jurddle/Mood-Lamp/images/schematic.jpg

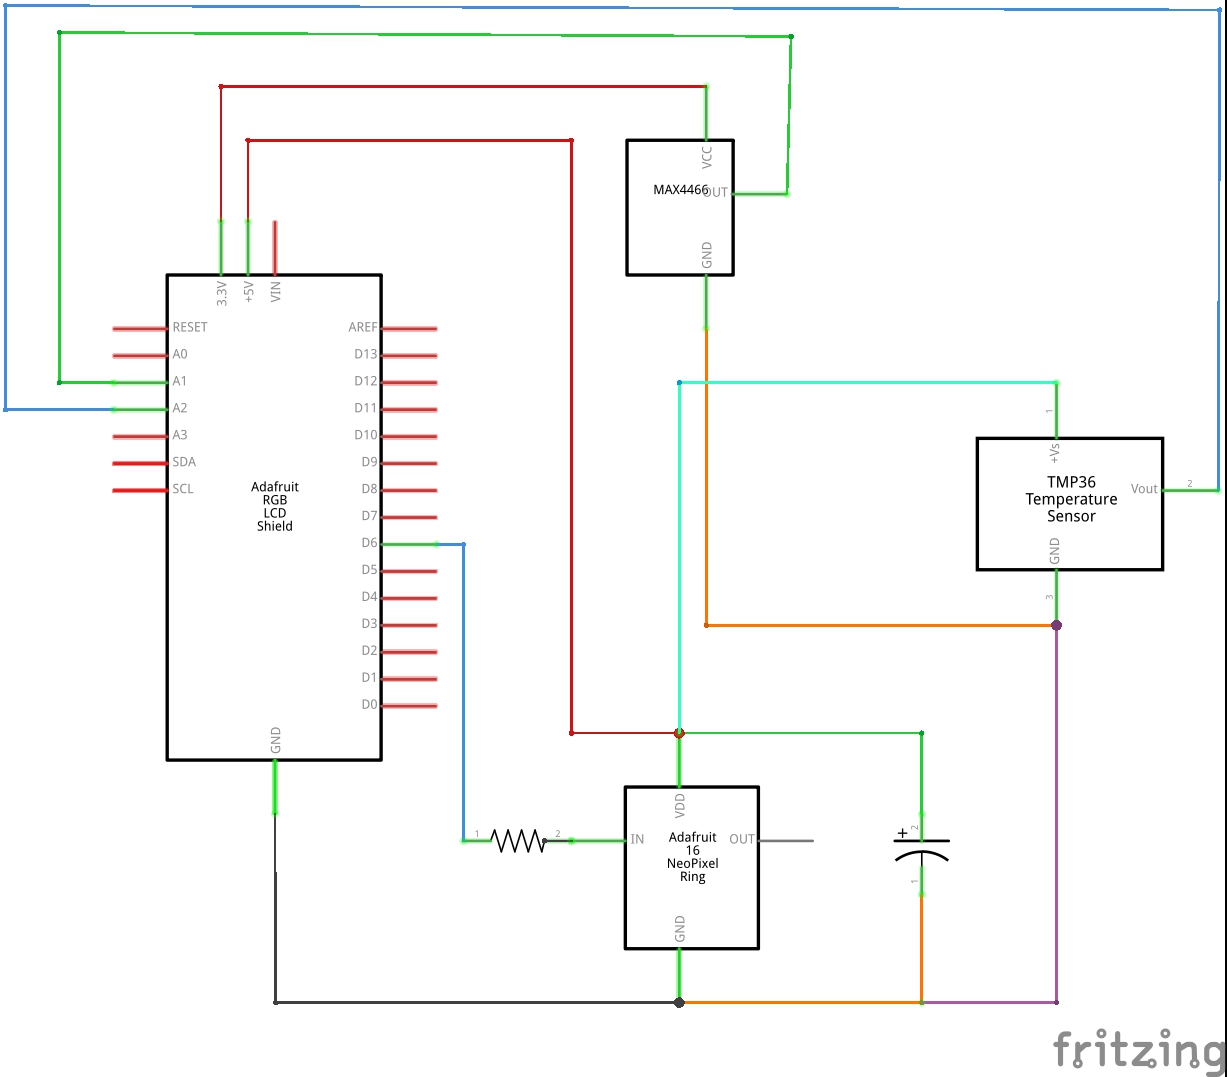
images/schematic.jpg
